jasonangelov/monocopter_flight_controller/pictures/READMEtemp.md

# Monocopter Flight Controller



ESP32-based autonomous flight controller for a single-rotor drone with thrust vectoring control.

## Features
- 200Hz cascade PID control loop
- IMU-based attitude stabilization (BNO055)
- LiDAR altitude hold (VL53L0X)
- WiFi telemetry and tuning interface
- Differential thrust yaw control

## Work in progress 
- Optical flow positioning (PMW3901)

## Hardware
- ESP32-WROOM-32
- Adafruit BNO055 IMU
- Matek 3901-L0X Optical Flow
- 4x servo-controlled fins
- 2x brushless motors with ESCs

## Setup
1. Install Arduino IDE with ESP32 support
2. Install required libraries (ESP32Servo, Adafruit BNO055)
3. Configure WiFi credentials in Config.h
4. Upload to ESP32
5. Connect via telnet to monocopter.local:23

## Commands
- `start` - Begin flight
- `stop` - Emergency stop
- `status` - View all parameters
- `throttle <1000-2000>` - Set base throttle
- `alt <cm>` - Set altitude target

# Flight Videos

### Trial 1
(https://www.youtube.com/watch?v=riI-cIHnShg)

### Trial 2
(https://youtu.be/cCDeujReH3Y)

### Trial 3
(https://www.youtube.com/watch?v=jJXlnwY6VRc)

# Design Pictures
## Current Version (V4)






## V3


## V2
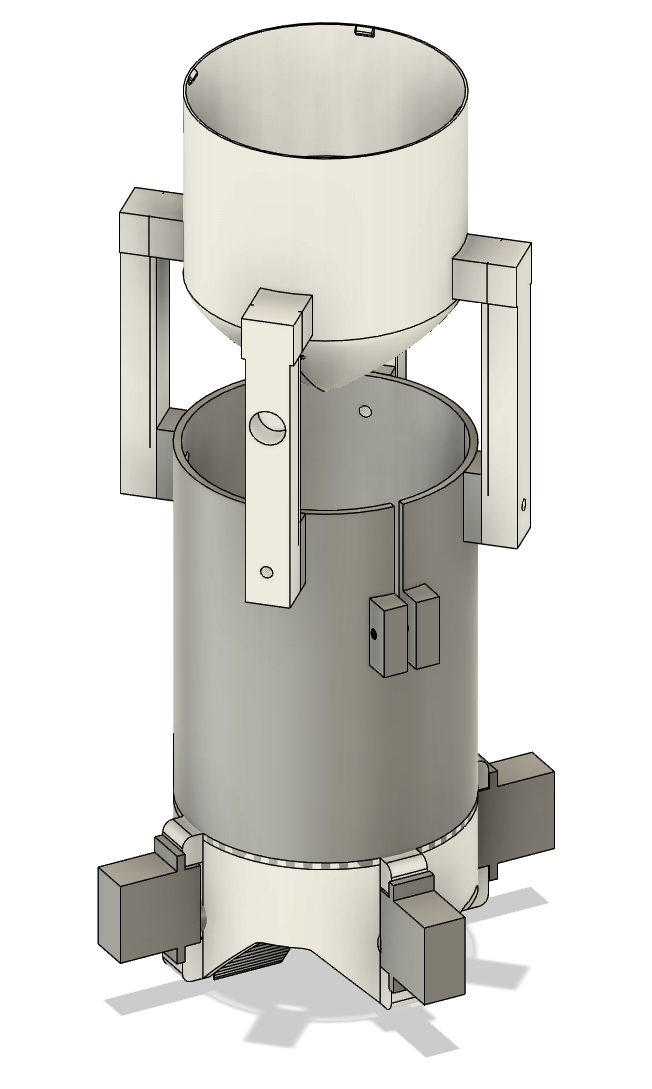
[picture p8: pictures/V2/V2.png]


## Testing Mount
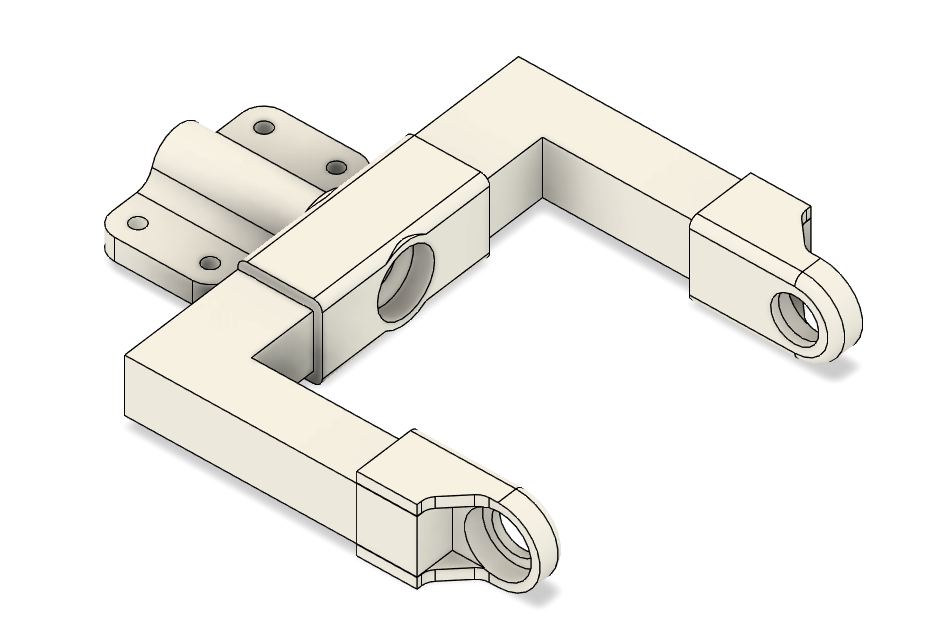
[picture p9: pictures/V2/Bench Assembly.png]


## V1
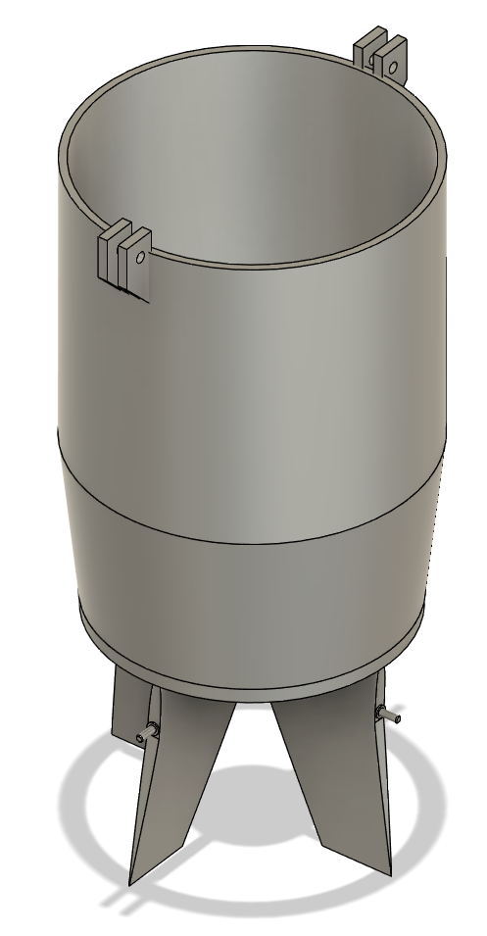
[picture p10: pictures/V1/V1.png]


## Authors
- Jason Angelov - UCLA Computer Science
- William Crowhurst - UCB Physics
