jasonangelov/monocopter_flight_controller/(commit log)

2025-09-01 Update GitHub Actions workflow for ESP32 firmware
2025-09-01 Update release workflow for Arduino project
2025-09-01 Refactor GitHub Actions workflow for Arduino compilation
2025-09-01 Refactor compile workflow for ESP32 firmware
    Updated the compile workflow to install required libraries individually and improved output logging.
2025-09-02 Add CAD design details for V4 version
    Added CAD design section with images and descriptions for V4.
2025-09-02 Revise CAD design section layout in README
    Updated the CAD design section to use aligned images with captions instead of a table format.
2025-09-02 Update CAD design section with table layout
2025-09-02 Update image path for V1 3D print in README
2025-09-02 Fix formatting of yaw control section in README
2025-09-03 Enhance README with V3 photos and CAD details
2025-09-03 Update CAD DESIGN version link in README
2025-09-03 Update CAD DESIGN link with badge
2025-09-03 Enhance CAD DESIGN section in README
    Updated CAD DESIGN section with additional URL information.
2025-09-03 Update CAD design link format in README
