jasonangelov/monocopter_flight_controller/pictures/V2/IMG_3846.JPG

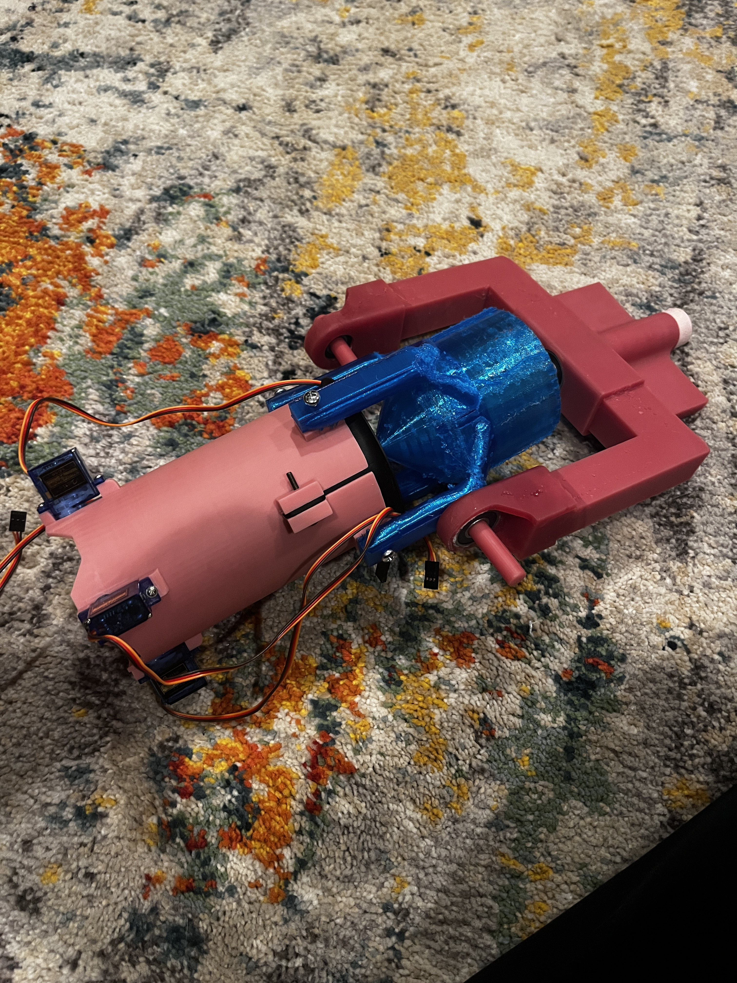
[picture p5: pictures/V2/v2_gimbal.JPG]
pictures/V2/IMG_3846.JPG
