jasonangelov/monocopter_flight_controller/pictures/V3/3.jpg

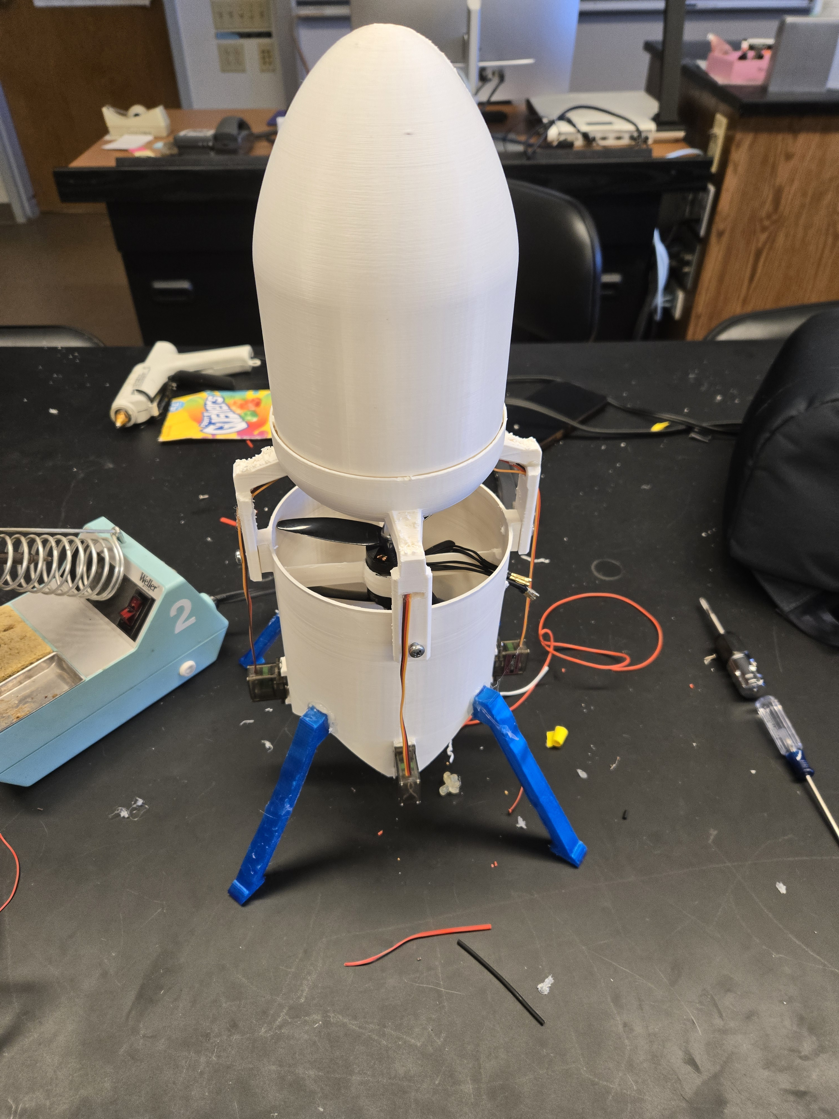
[picture p6: pictures/V3/3.jpg]
pictures/V3/3.jpg
